aldrin7g/WildlifeMitigation/OutputPics/Purchase.jpg

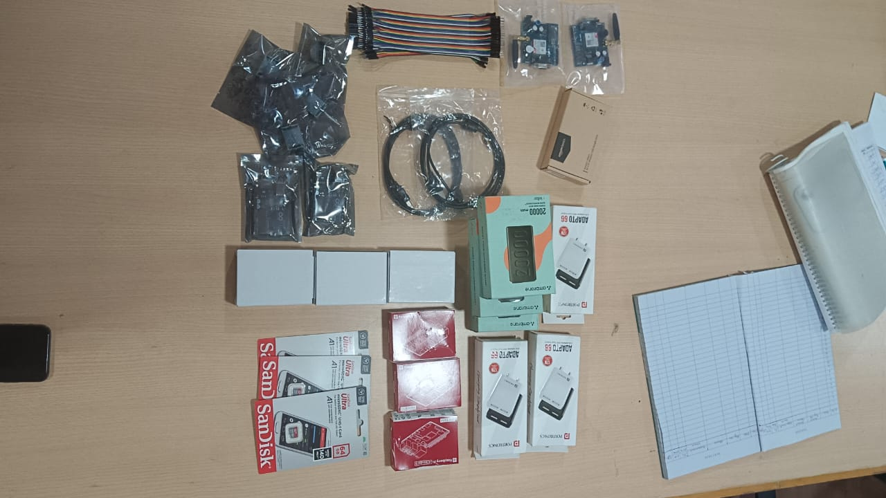
OutputPics/Purchase.jpg
