aldrin7g/WildlifeMitigation/OutputPics/3D-Printing.jpg

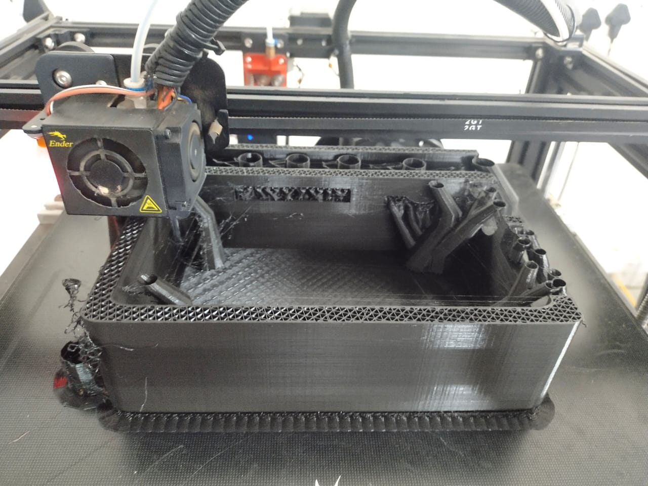
OutputPics/3D-Printing.jpg
