aldrin7g/WildlifeMitigation/Misc/Work Breakdown Structure Template.pdf

# IOT BASED REMOTE MONITORING AND ALTERING OF HUMAN - ELEPHANT MITIGATION

### SYSTEM DESIGN

Object | Algorithm | Camera module | Instalation
Components | Model evaluation | Raspberry pi4 | Monitoring
Data flow | Testing | LORAWAN | Updates
Integration | Alerting | GSM SIM800A | Documentation
SOFTWARE | HARDWARE | Deployment

# Application Development Work Breakdown Structure

Power bank
