aldrin7g/WildlifeMitigation/UBA_final.pdf

## SAFE PATH NETWORK

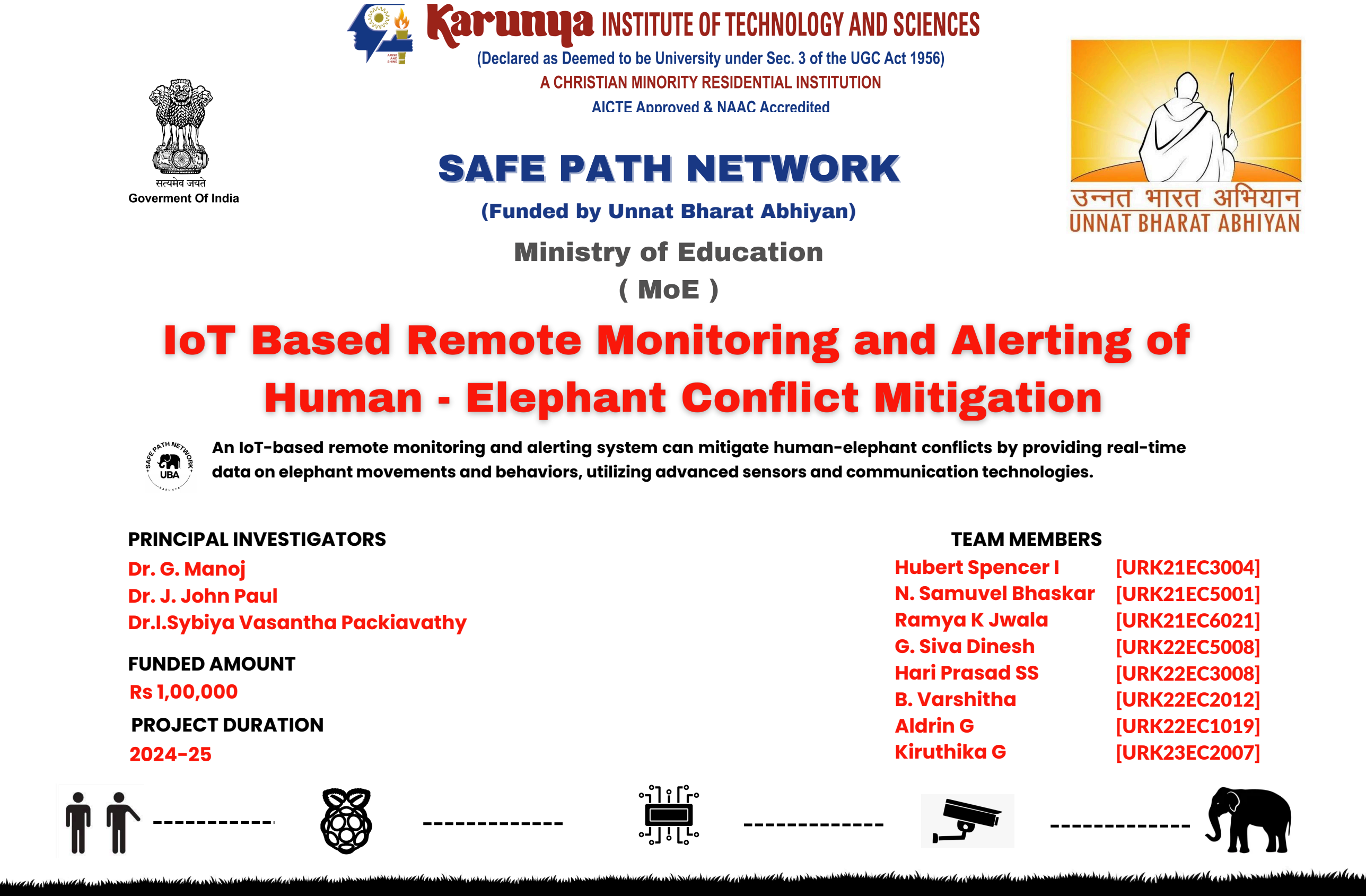
[picture p11: page 1]

(Funded by Unnat Bharat Abhiyan)

An IoT-based remote monitoring and alerting system can mitigate human-elephant conflicts by providing real-time data on elephant movements and behaviors, utilizing advanced sensors and communication technologies.

PRINCIPAL INVESTIGATORS
Dr. G. Manoj
Dr. J. John Paul
Dr.I.Sybiya Vasantha Packiavathy

TEAM MEMBERS
Hubert Spencer I
N. Samuvel Bhaskar
Ramya K Jwala
G. Siva Dinesh
Hari Prasad SS
B. Varshitha
Aldrin G
Kiruthika G

PROJECT DURATION
2024-25

FUNDED AMOUNT
Rs 1,00,000

[URK21EC3004]
[URK21EC5001]
[URK21EC6021]
[URK22EC5008]
[URK22EC3008]
[URK22EC2012]
[URK22EC1019]
[URK23EC2007]

Ministry of Education
( MoE )
