aldrin7g/WildlifeMitigation/Misc/UBA-project.pdf

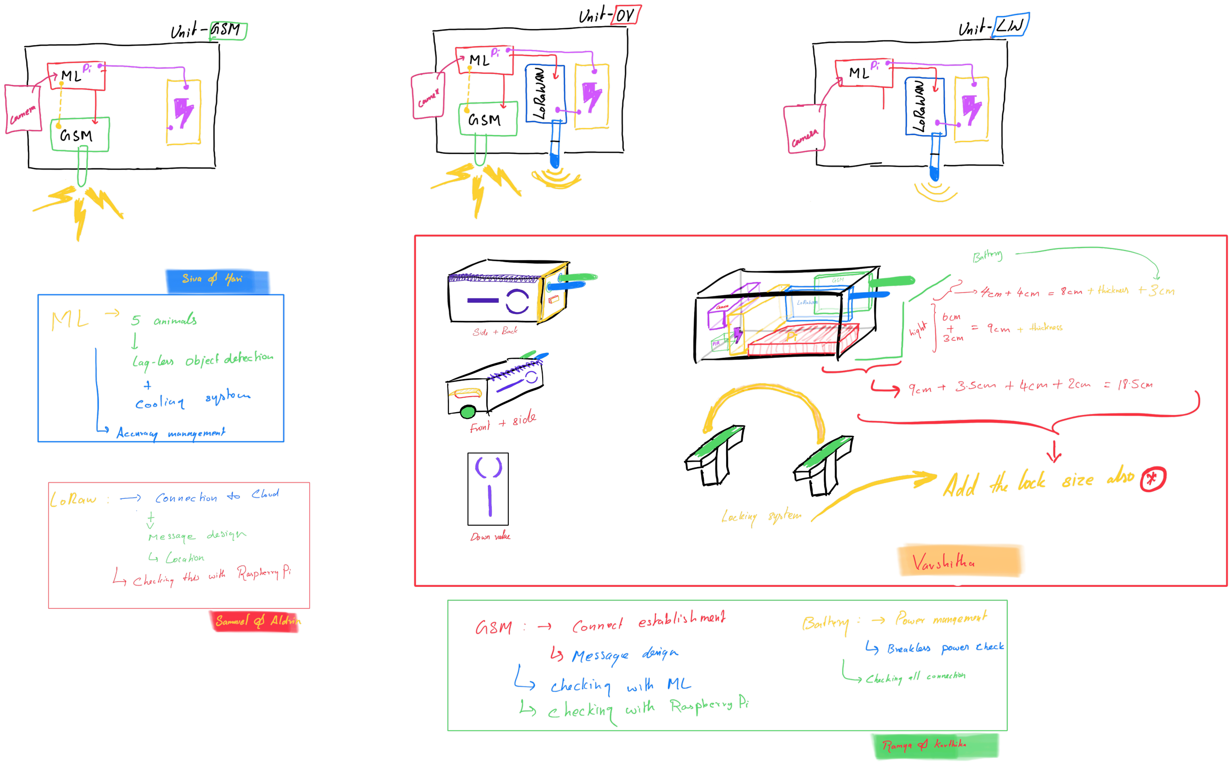
[picture p12: page 1]
