aldrin7g/WildlifeMitigation/Diagrams/Diagram.png

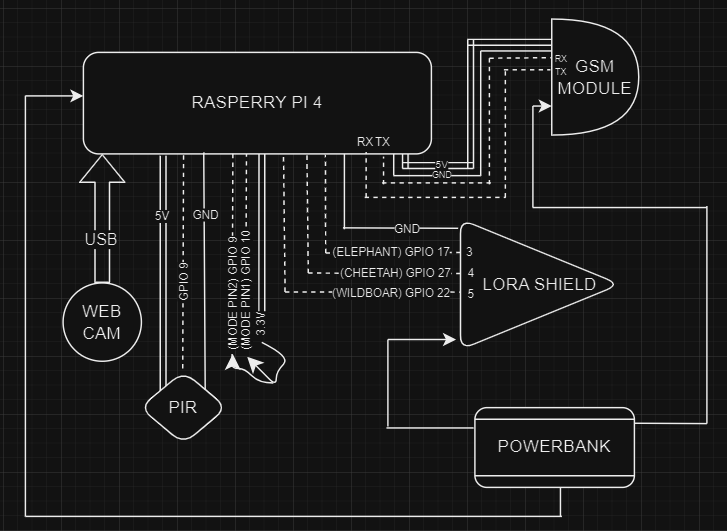
Diagrams/Diagram.png
