aldrin7g/WildlifeMitigation/FiedTripPics/1.jpg

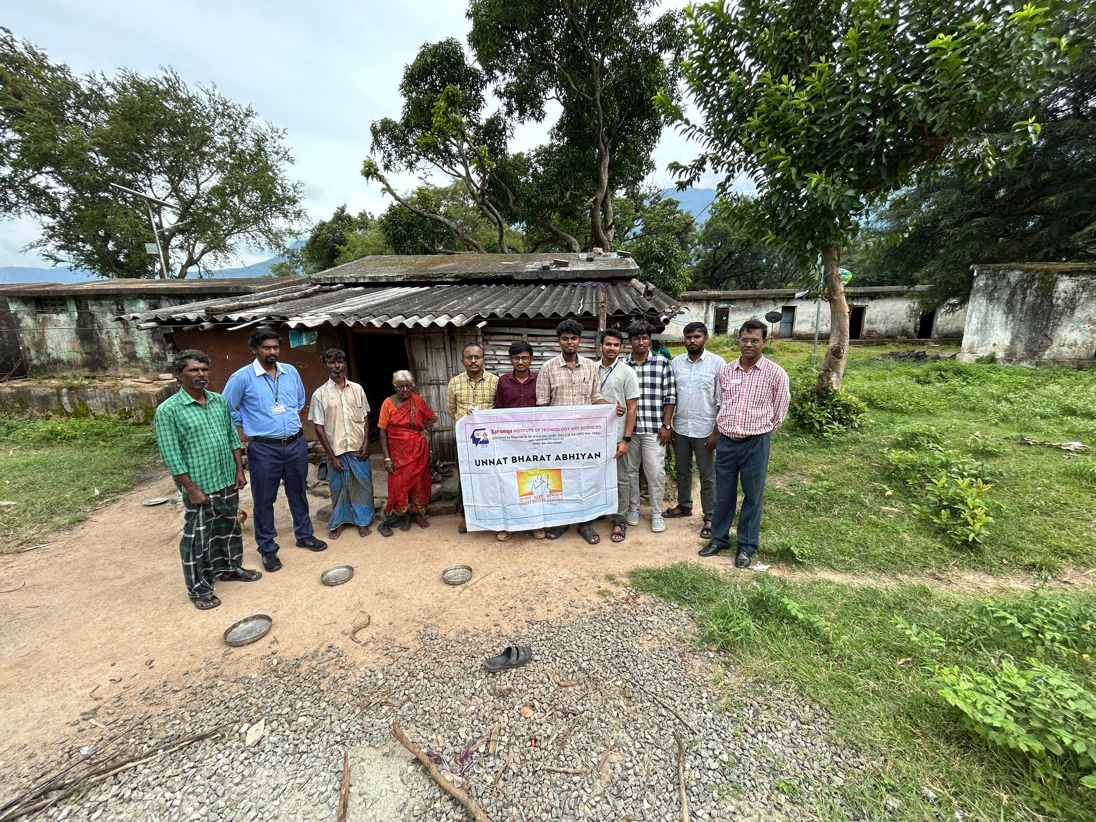
FiedTripPics/1.jpg
