aldrin7g/WildlifeMitigation/FiedTripPics/2.jpg

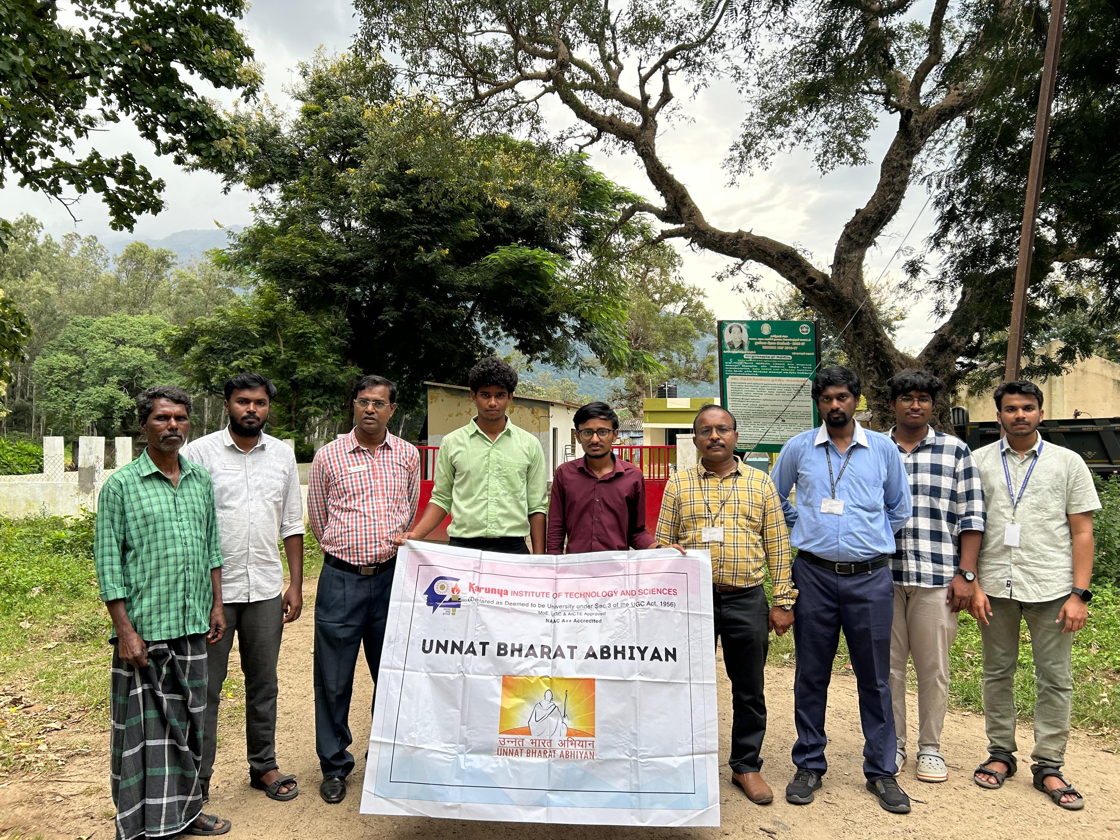
FiedTripPics/2.jpg
