aldrin7g/WildlifeMitigation/FiedTripPics/3.jpg

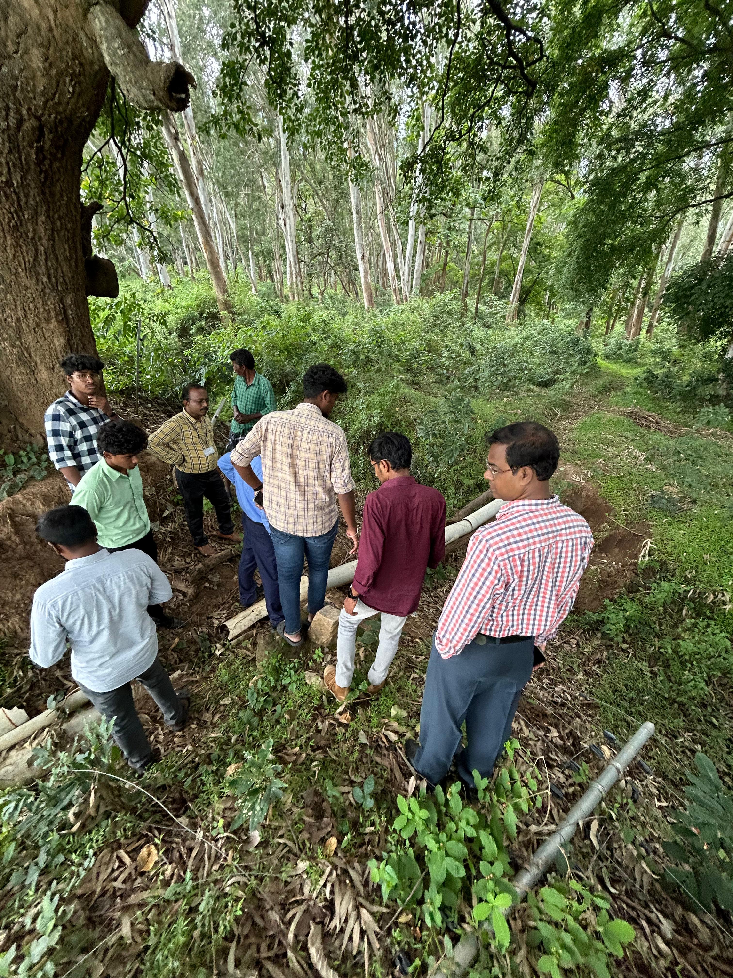
FiedTripPics/3.jpg
