aldrin7g/WildlifeMitigation/FiedTripPics/4.jpg

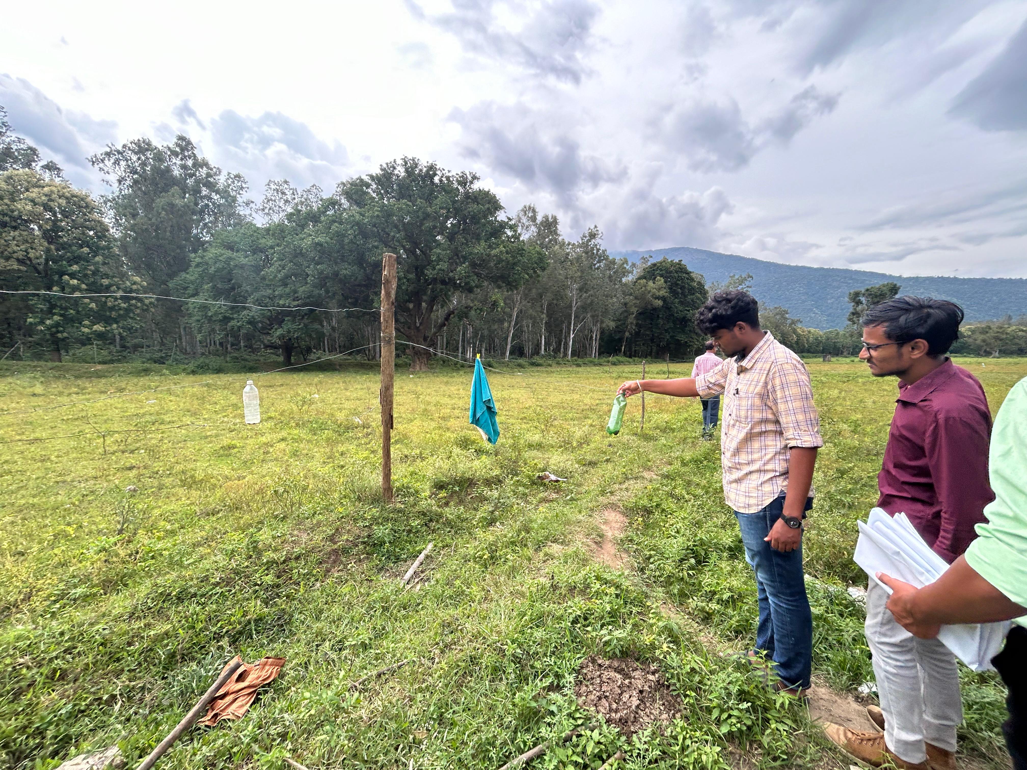
FiedTripPics/4.jpg
