aldrin7g/WildlifeMitigation/Images/Certificate.jpeg

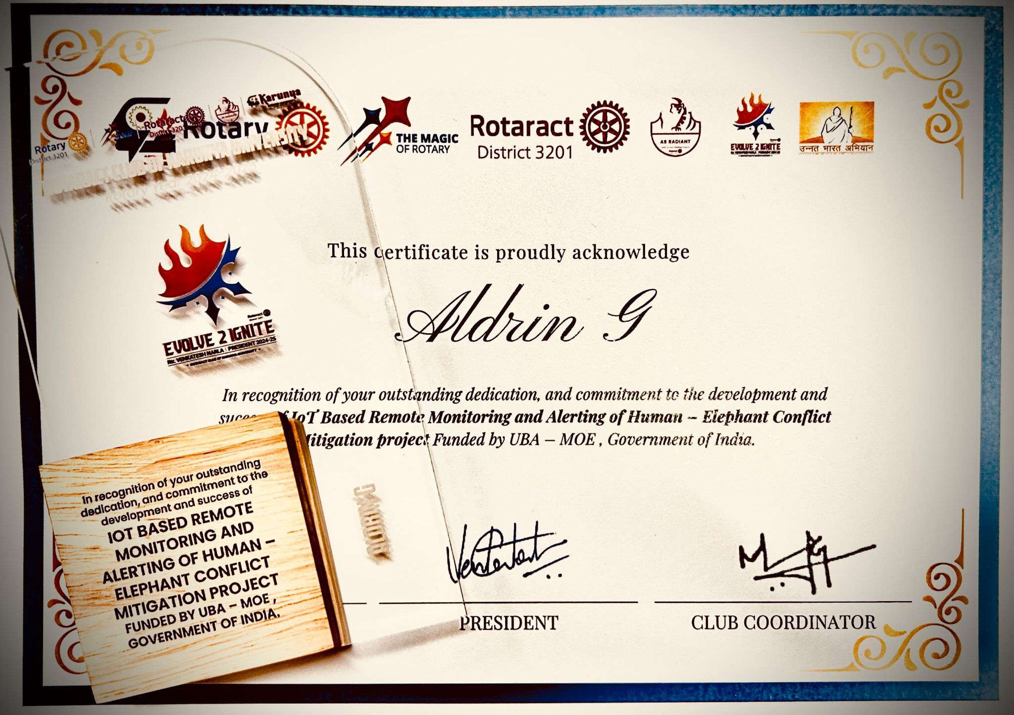
Images/Certificate.jpeg
