aldrin7g/WildlifeMitigation/Images/Group.jpeg

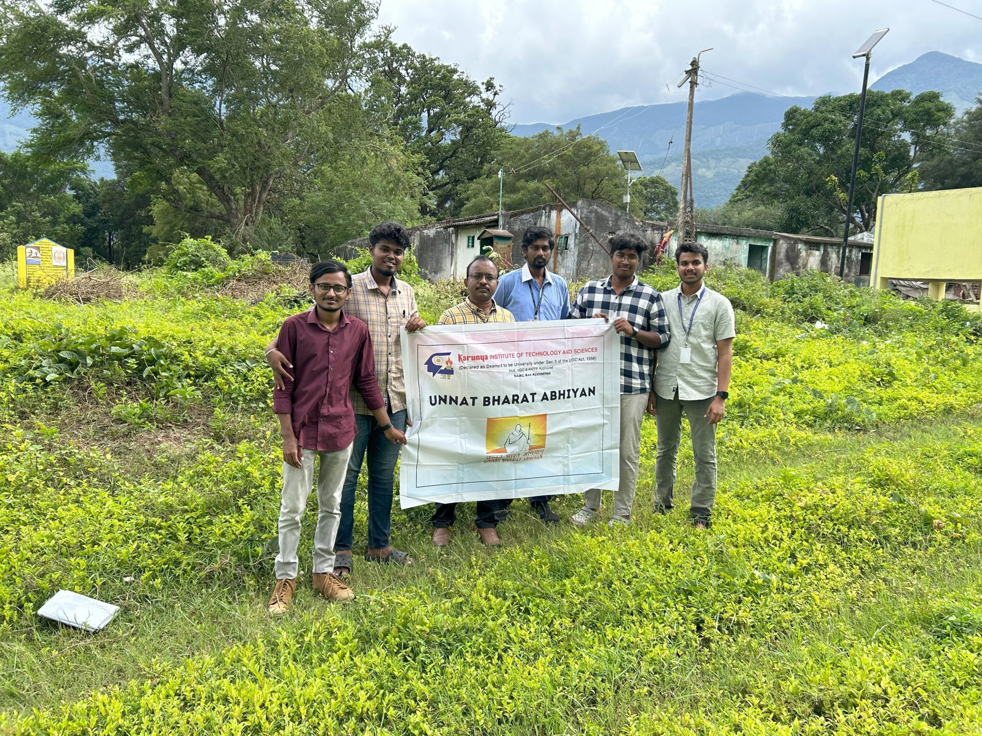
Images/Group.jpeg
