aldrin7g/WildlifeMitigation/Images/Prize.jpeg

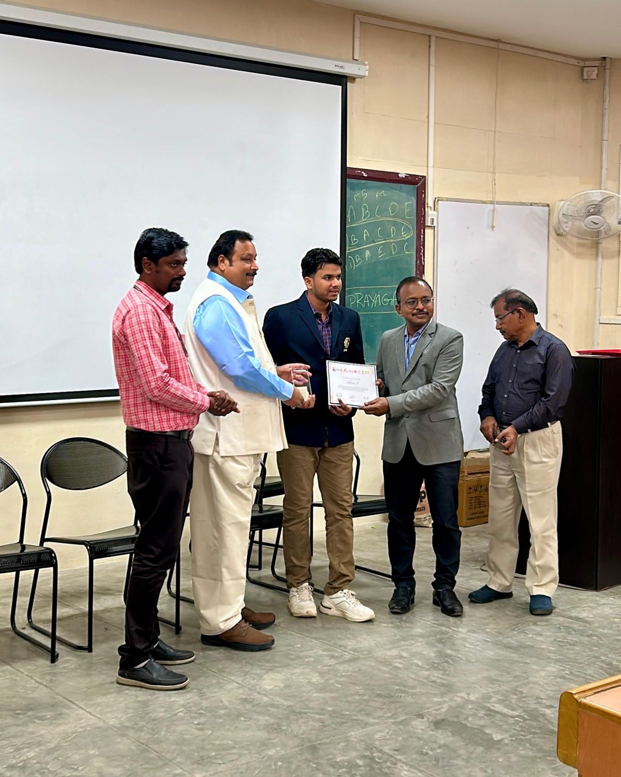
Images/Prize.jpeg
