aldrin7g/WildlifeMitigation/Images/Product.jpeg

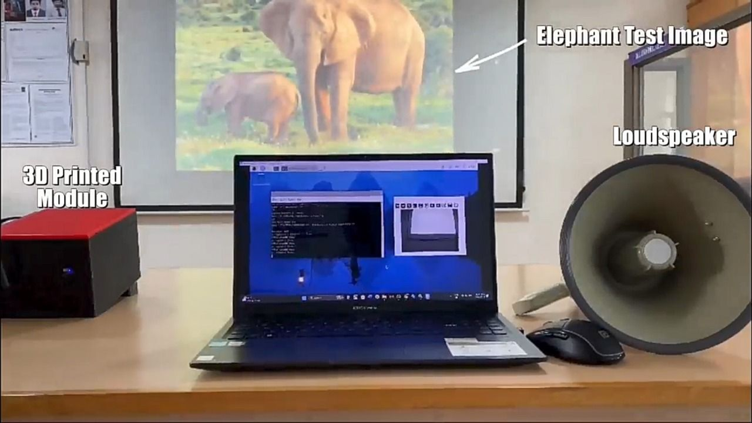
Images/Product.jpeg
