aldrin7g/WildlifeMitigation/Misc/invoice.jpg

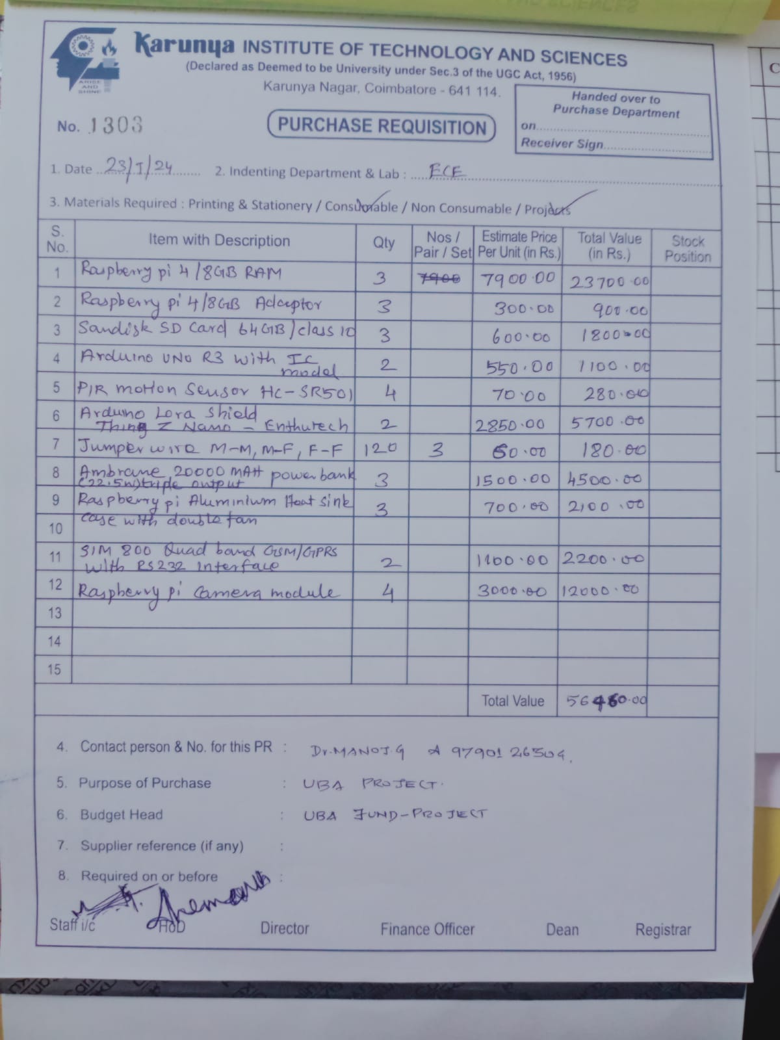
Misc/invoice.jpg
