aldrin7g/WildlifeMitigation/OutputPics/3D_Box1.jpg

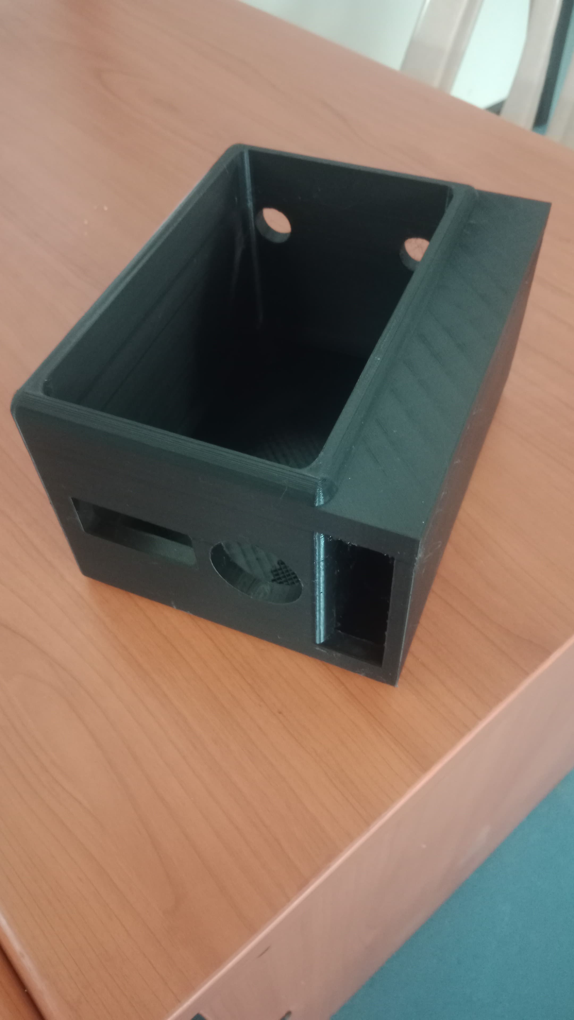
OutputPics/3D_Box1.jpg
