aldrin7g/WildlifeMitigation/OutputPics/3D_Box2.jpg

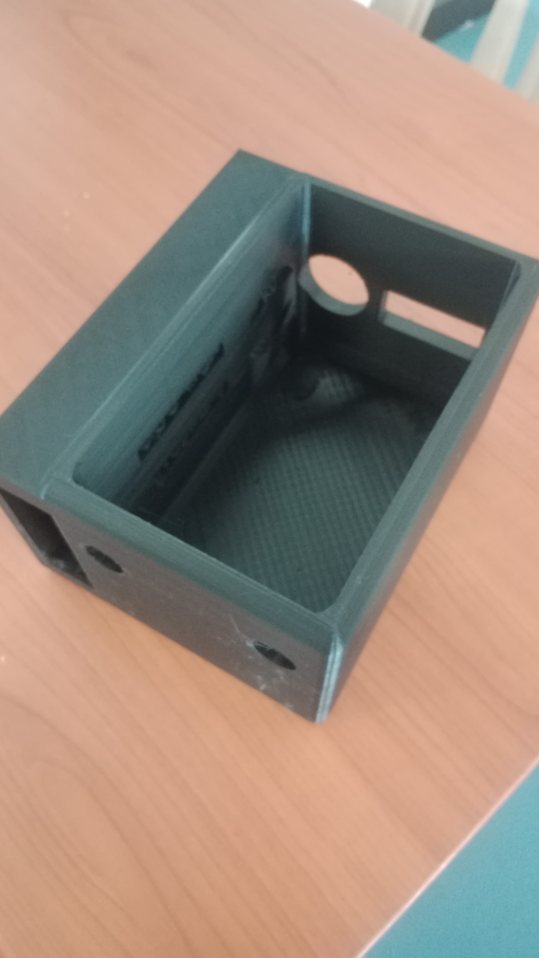
OutputPics/3D_Box2.jpg
