aldrin7g/WildlifeMitigation/OutputPics/interfacing.jpg

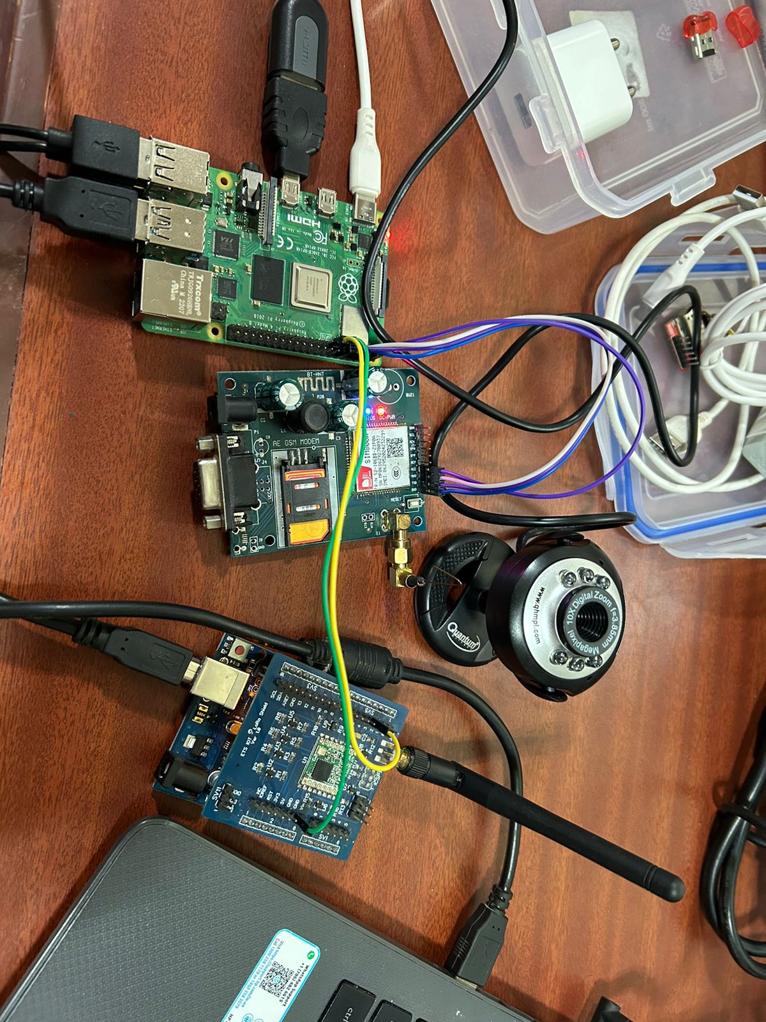
OutputPics/interfacing.jpg
