aldrin7g/WildlifeMitigation/OutputPics/LoRaDisplay.jpg

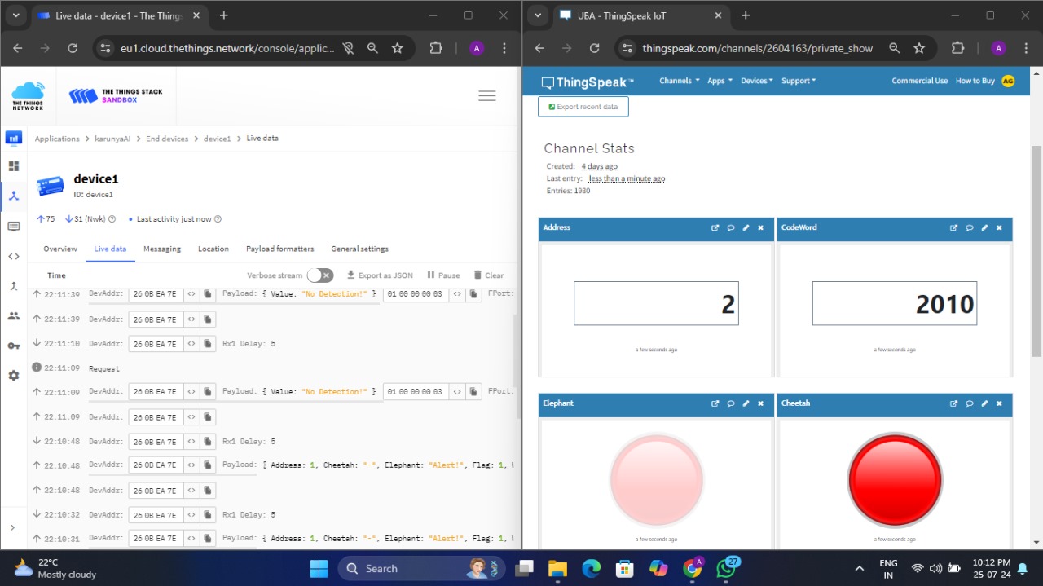
OutputPics/LoRaDisplay.jpg
