aldrin7g/WildlifeMitigation/OutputPics/LoRaRange.jpg

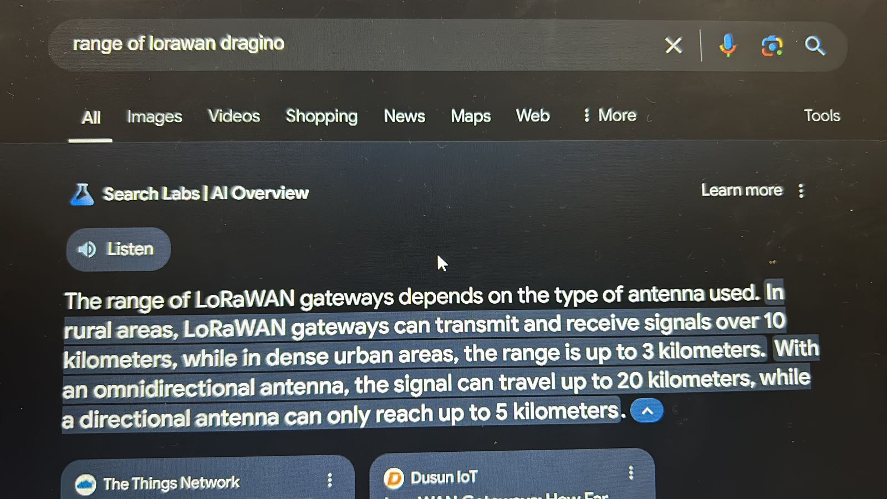
OutputPics/LoRaRange.jpg
