aldrin7g/WildlifeMitigation/OutputPics/NewDesign.jpg

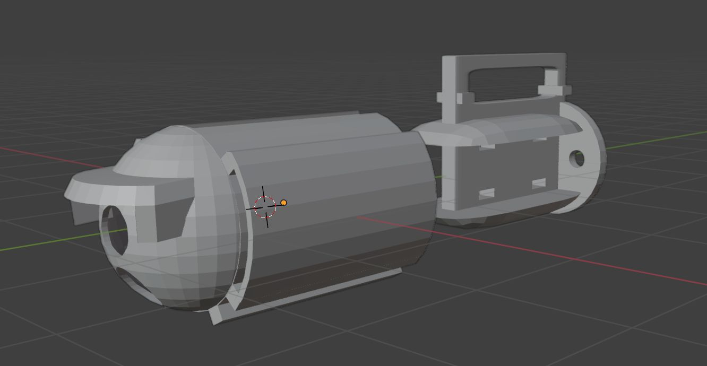
OutputPics/NewDesign.jpg
