aldrin7g/WildlifeMitigation/OutputPics/NightVision.jpg

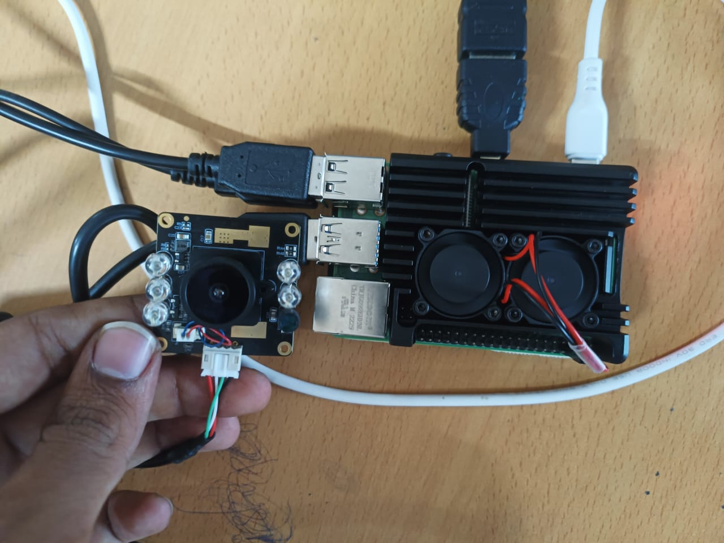
OutputPics/NightVision.jpg
