aldrin7g/WildlifeMitigation/OutputPics/SMS_Alert.jpg

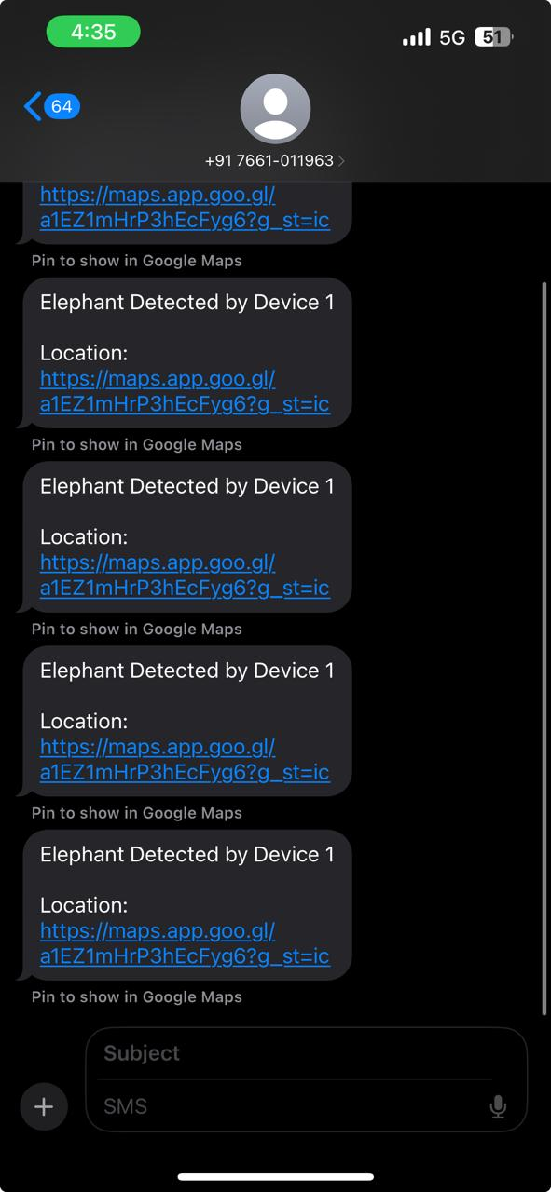
OutputPics/SMS_Alert.jpg
