aldrin7g/WildlifeMitigation/OutputPics/YOLOv5.jpg

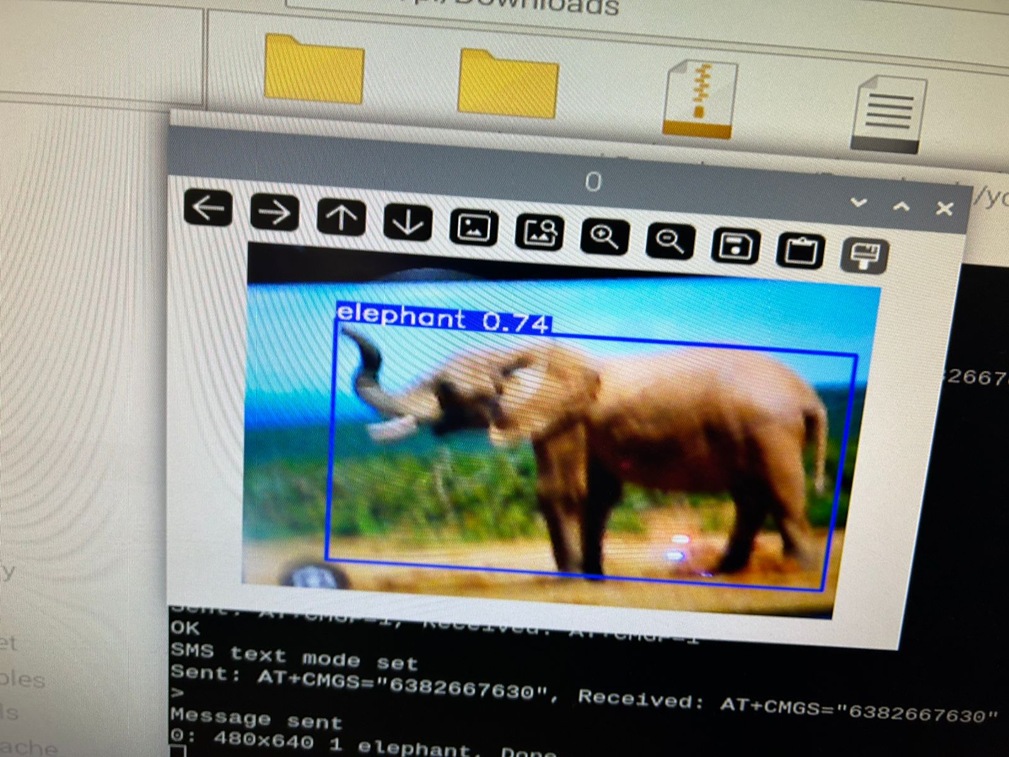
OutputPics/YOLOv5.jpg
