aldrin7g/WildlifeMitigation/tract.png

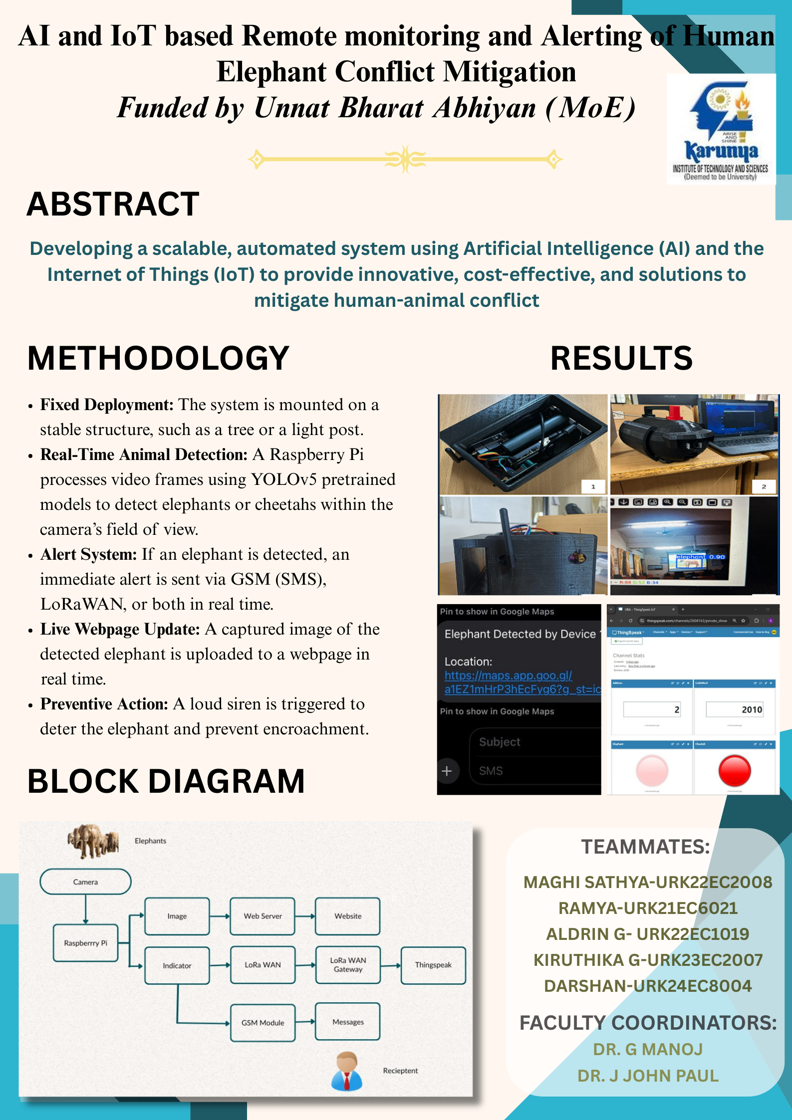
tract.png
