aldrin7g/WildlifeMitigation/Misc/Purchase.xlsx

S No. | Components | Link | Quantity | Cost
1 | Raspberry Pi 4 Model-B with 4 GB RAM | https://robu.in/product/raspberry-pi-4-model-b-with-8-gb-ram/ | 3 | 7,200 X 3 =21,600
2 | SIM800A Quad Band GSM/GPRS Module with RS232 Interface | https://robu.in/product/sim800a-quad-band-gsmgprs-module-rs232-interface/ | 2 | 1,000 X 2 = 2,000
3 | Aluminum Heat Sink Case with Double Fans for Raspberry Pi 4B – Black | https://robocraze.com/products/raspberry-pi-metal-aluminium-case-with-double-fans-for-raspberry-pi-4b-black | 3 | 500 X 3 =1,500
4 | Arduino LoRa shield (ThingZkit Nano, by enthutech) | https://www.enthutech.co.in/electronic-development-board.html#lora-shield-for-Arduino | 2 | 2,850 X 2 =5,700
5 | Raspberry Pi Camera Module (F), Supports Night Vision, Adjustable-Focus | https://tannatechbiz.com/arducam-1080p-day-night-vision-usb-camera-module-forcomputer-2mp-aut-omatic-ir-cut-switching-all-day-image-usb2-0-webcam-board-with-i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 | 4 | 3,000 X 4 =12,000
6 | Ambrane 20000mAh Powerbank,22.5W Fast Charging, Triple Output | https://amzn.in/d/08kR59XD | 3 | 1,500 X 3 =4,500
7 | Portronics adapto 66 2.4A 12W dual USB port 5V/2.4A wall charger | https://www.amazon.in/Portronics-66-POR-1066-Charging-Adapter/dp/B08LQNKJH9?adgrpid=60608076162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 | 3 | 210 X 3 =630
8 | PIR Motion Sensor Detector Module HC-SR501 | https://robocraze.com/products/hcsr501-pir-motion-sensor-passive-infrared-sensor | 4 | 57 X 4 = 228
9 | Jumper wires | https://robu.in/product/20-cm-40-pin-dupont-male-male-male-female-female-female-cable-combo/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 | 1 | 113 X 1 = 113
10 | SanDisk Micro SDXC USH-I 64GB Class 10 Memory Card | https://robu.in/product/sandisk-micro-sdxc-ush-i-64gb-class-10-memory-card/ | 3 | 600 X 3 = 1,800
11 | Arduino Uno R3 with cable | https://robu.in/product/arduino-uno-r3/ | 2 | 422 X 2 = 844
